mp-commits/Volvo_MELBUS_bluetooth_adapter/Casing/FreeCad/version1.FCStd

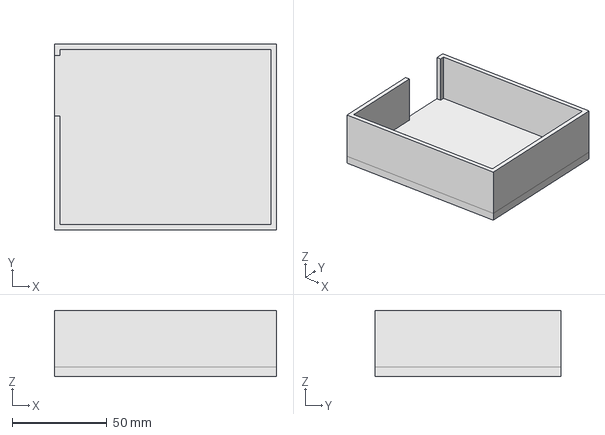
[picture p1: CAD file, 2022-04-23]
Casing/FreeCad/version1.FCStd
117.0 x 98.0 x 35.0 mm
