mp-commits/Volvo_MELBUS_bluetooth_adapter/KiCad/1.2/volvo_bt_board/volvo_bt_board.kicad_pcb

## KiCad design KiCad/1.2/volvo_bt_board/volvo_bt_board.kicad_pcb (2022-04-23)

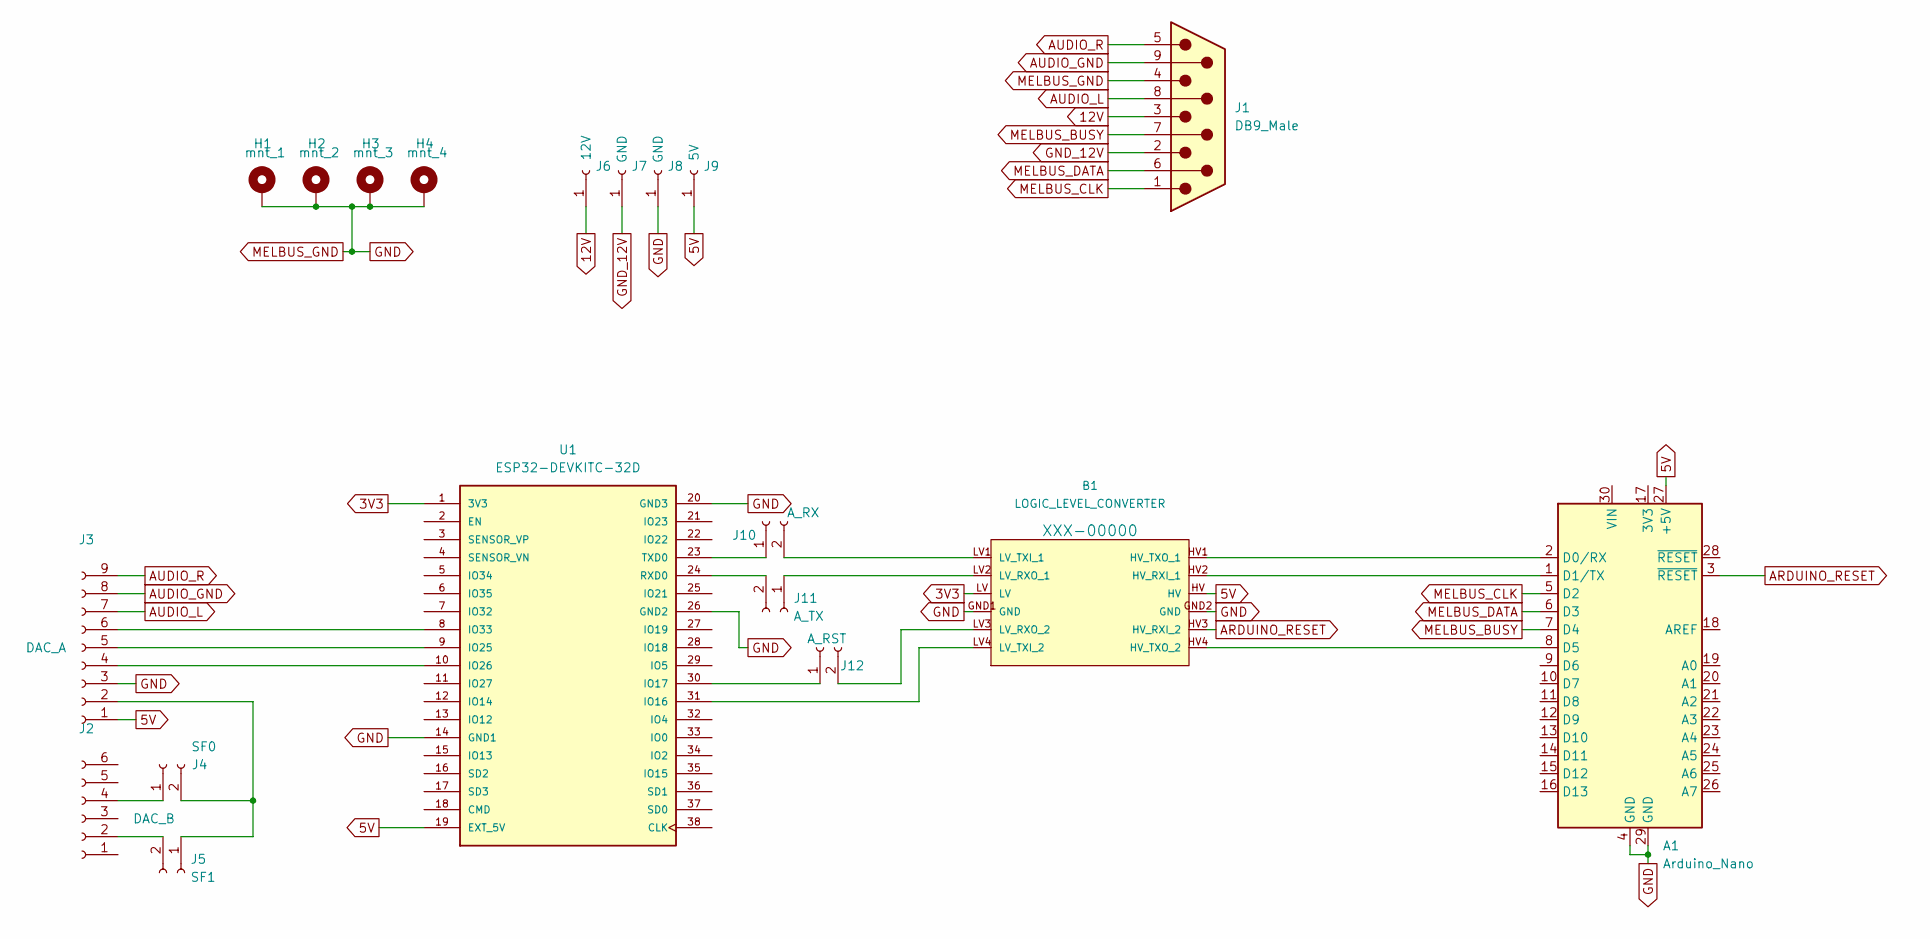
[picture p2: schematic volvo_bt_board.kicad_sch, Prototype Volvo MELBUS compatible bluetooth receiver]

Parts:
A1: Arduino_Nano
B1: LOGIC_LEVEL_CONVERTER; SPARKFUN_LOGIC_LEVEL_CONVERTER
H1: mnt_1; MountingHole_2.5mm_Pad
H2: mnt_2; MountingHole_2.5mm_Pad
H3: mnt_3; MountingHole_2.5mm_Pad
H4: mnt_4; MountingHole_2.5mm_Pad
J1: DB9_Male; DSUB-9_Male_Horizontal_P2.77x2.84mm_EdgePinOffset7.70mm_Hou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
J2: DAC_B; PinSocket_1x06_P2.54mm_Vertical
J3: DAC_A; PinSocket_1x09_P2.54mm_Vertical
J4: SF0; 1X02_NO_SILK
J5: SF1; 1X02_NO_SILK
J6: 12V; PinSocket_1x01_P2.54mm_Vertical
J7, J8: GND; PinSocket_1x01_P2.54mm_Vertical
J9: 5V; PinSocket_1x01_P2.54mm_Vertical
J10: A_RX; 1X02_NO_SILK
J11: A_TX; 1X02_NO_SILK
J12: A_RST; 1X02_NO_SILK
U1: ESP32-DEVKITC-32D; MODULE_ESP32-DEVKITC-32D; PARTREV 4

Connections:
3V3: B1.LV, U1.1 (3V3)
5V: A1.27 (+5V), B1.HV, J3.1, J9.1, U1.19 (EXT_5V)
12V: J1.3, J6.1
ARDUINO_RESET: A1.3 (~RESET), B1.HV3 (HV_RXI_2)
AUDIO_GND: J1.9, J3.8
AUDIO_L: J1.8, J3.7
AUDIO_R: J1.5, J3.9
GND: A1.4 (GND), A1.29 (GND), B1.GND1 (GND), B1.GND2 (GND), H1.1, H2.1, H3.1, H4.1, J1.4, J3.3, J8.1, U1.14 (GND1), U1.20 (GND3), U1.26 (GND2)
GND_12V: J1.2, J7.1
MELBUS_BUSY: A1.7 (D4), J1.7
MELBUS_CLK: A1.5 (D2), J1.1
MELBUS_DATA: A1.6 (D3), J1.6
unnamed: A1.1 (D1/TX), B1.HV2 (HV_RXI_1)
unnamed: A1.2 (D0/RX), B1.HV1 (HV_TXO_1)
unnamed: A1.8 (D5), B1.HV4 (HV_TXO_2)
unnamed: B1.LV1 (LV_TXI_1), J10.2
unnamed: B1.LV2 (LV_RXO_1), J11.1
unnamed: B1.LV3 (LV_RXO_2), J12.2
unnamed: B1.LV4 (LV_TXI_2), U1.31 (IO16)
unnamed: J2.2, J5.2
unnamed: J2.4, J4.1
unnamed: J3.2, J4.2, J5.1
unnamed: J3.4, U1.10 (IO26)
unnamed: J3.5, U1.9 (IO25)
unnamed: J3.6, U1.8 (IO33)
unnamed: J10.1, U1.23 (TXD0)
unnamed: J11.2, U1.24 (RXD0)
unnamed: J12.1, U1.30 (IO17)

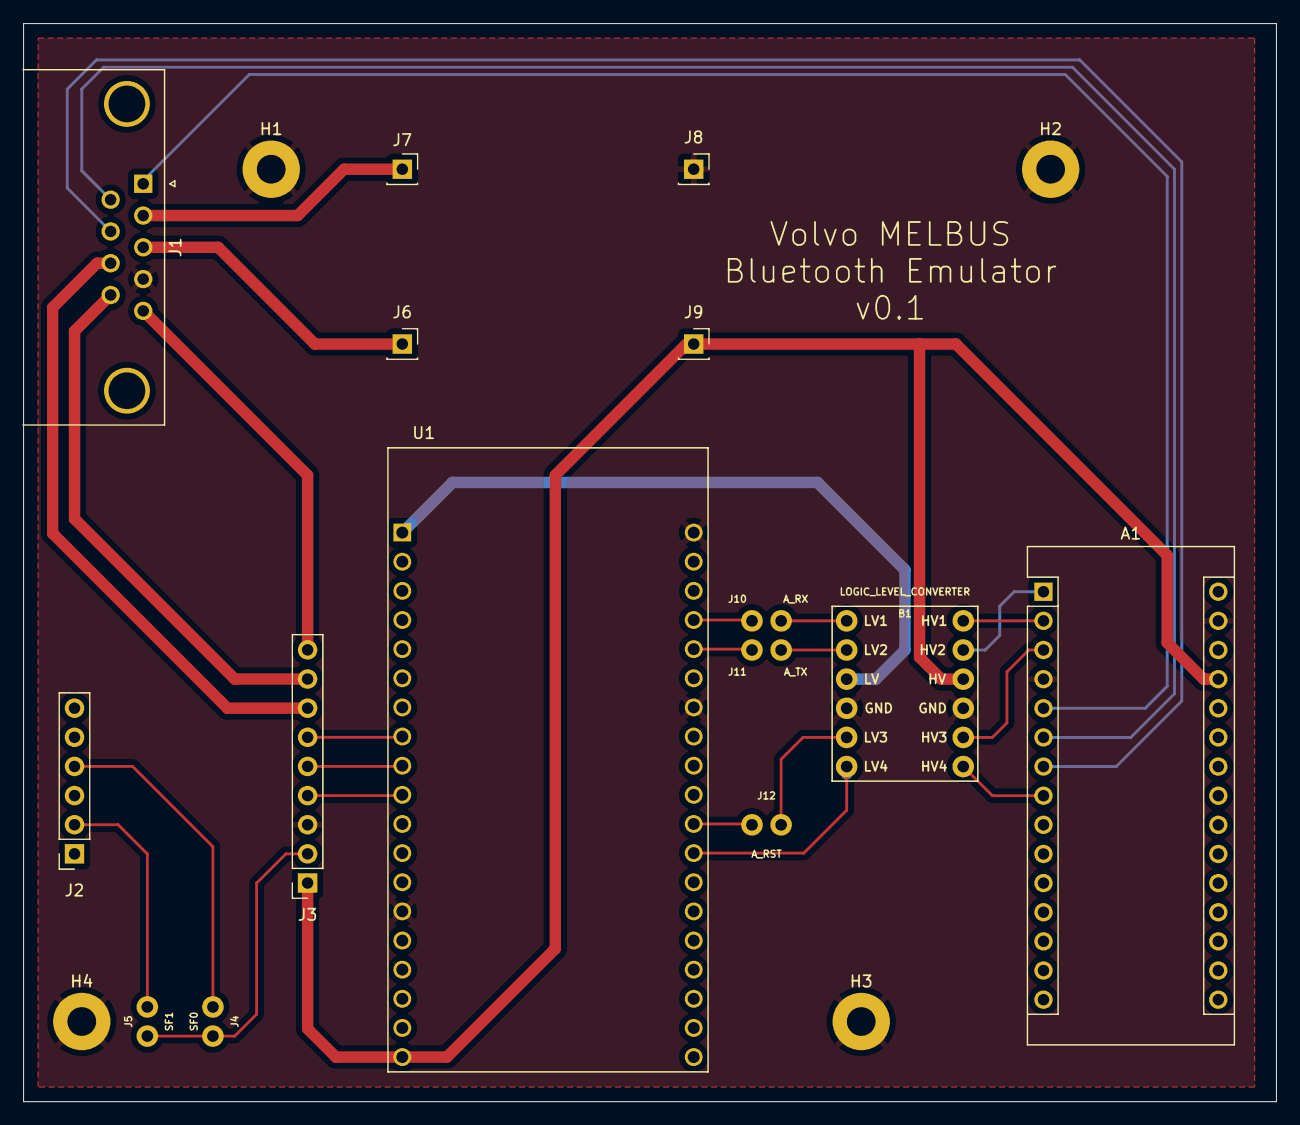
[picture p3: board volvo_bt_board.kicad_pcb from above]

Board: 2 copper layers, 109.2 x 94.0 mm, 19 parts (0 on the bottom side), 28 nets.
