mp-commits/Volvo_MELBUS_bluetooth_adapter/Bluetooth_receiver_ESP32/src/media/media_control.cpp

/**
 * @file media_control.cpp
 * @author Mikael Penttinen (mikael.penttinen3@gmail.com)
 * @brief 
 * @version 0.1
 * @date 2022-04-02
 * 
 * @copyright Copyright (c) 2022
 * 
 */
#include "media_control.h"
#include "Arduino.h"
#include "dev_print.h"

MediaControl::MediaControl()
{
    m_melbusInitDone = false;
    m_debugEnabled = false;
    m_sink = nullptr;
}

void MediaControl::SetSink(BluetoothA2DPSink* sink)
{
    m_sink = sink;
}

MediaControl::~MediaControl()
{

}

bool MediaControl::IsMelbusInitDone()
{
    return m_melbusInitDone;
}

void MediaControl::ResetMelbusInitDone()
{
    m_melbusInitDone = false;
}

void MediaControl::Task()
{
    if (m_sink == nullptr)
    {
        return;
    }

    MEDIA_Command_e mediaCommand = m_interface.TryGetCommand();
    if (mediaCommand != MEDIA_NO_COMMAND)
    {
        if (m_debugEnabled)
        {
            m_interface.SerialPrintCommand(mediaCommand);
        }

            switch (mediaCommand)
        {
        case MEDIA_PLAY:
            m_sink->play();
            break;
        case MEDIA_PAUSE:
            m_sink->pause();
            break;
        case MEDIA_NEXT_TRACK:
            m_sink->next();
            break;
        case MEDIA_PREVIOUS_TRACK:
            m_sink->previous();
            break;
        case MEDIA_NEXT_DISC:
            m_sink->set_volume(m_sink->get_volume()+10);
            PRINTF1("DAC Vol set to %i\n", m_sink->get_volume());
            break;
        case MEDIA_PREVIOUS_DISC:
            m_sink->set_volume(m_sink->get_volume()-10);
            PRINTF1("DAC Vol set to %i\n", m_sink->get_volume());
            break;
        case MEDIA_INFO_MELBUS_INIT_DONE:
            m_melbusInitDone = true;
            break;
        case MEDIA_FAST_FORWARD:
            m_sink->fast_forward();
            break;
        case MEDIA_FAST_REVERSE:
            m_sink->rewind();
            break;
        case MEDIA_RANDOM:
            RandomNextTrack();
        default:
            break;
        }
    }
}

void MediaControl::SetDebug(bool set)
{
    m_debugEnabled = set;
}

void MediaControl::RandomNextTrack()
{
    const uint32_t timeStamp = millis();
    const uint32_t skipCount = timeStamp % 7;
    for(uint32_t i = 0; i < skipCount; i++)
    {
        m_sink->next();
    }
}
