mp-commits/Volvo_MELBUS_bluetooth_adapter/Bluetooth_receiver_ESP32/include/melbus_controller.h

/**
 * @file melbus_controller.h
 * @author Mikael Penttinen (mikael.penttinen3@gmail.com)
 * @brief 
 * @version 0.1
 * @date 2022-04-03
 * 
 * @copyright Copyright (c) 2022
 * 
 */

#ifndef MELBUS_CONTROLLER_H
#define MELBUS_CONTROLLER_H

#include "project_pinconfig.h"
#include "media_control.h"
#include "Arduino.h"

#define MELBUS_INIT_TIMEOUT_MS 5000 // Allow 5 sec for melbus init before reset

class MelbusController
{
public:
    MelbusController(MediaControl* control);
    ~MelbusController();
    void Init();
    void Reset();
    void SetEnable(bool enable);

    void Task();
private:
    MediaControl* m_mediaControl;
    uint32_t m_initBeginTime_ms;
};

#endif
