mp-commits/Volvo_MELBUS_bluetooth_adapter/Bluetooth_receiver_ESP32/src/media/media_interface.cpp

/**
 * @file media_interface.cpp
 * @author Mikael Penttinen (mikael.penttinen3@gmail.com)
 * @brief 
 * @version 0.1
 * @date 2022-04-02
 * 
 * @copyright Copyright (c) 2022
 * 
 */

#include "media_interface.h"
#include "Arduino.h"
#include <stdint.h>
#include "dev_print.h"

// Bytes for decoding commands
#define COM_HEADER          (uint8_t)(0xA0)
#define COM_UNKNOWN         (uint8_t)(0x00)
#define COM_PLAY            (uint8_t)(0x01)
#define COM_PAUSE           (uint8_t)(0x02)
#define COM_NEXT            (uint8_t)(0x03)
#define COM_PREV            (uint8_t)(0x04)
#define COM_RANDOM          (uint8_t)(0x05)
#define COM_NEXT_DISC         (uint8_t)(0x06)
#define COM_PREVIOUS_DISC       (uint8_t)(0x07)
#define COM_FAST_FORWARD    (uint8_t)(0x08)
#define COM_FAST_REVERSE    (uint8_t)(0x09)
#define COM_SCAN_MODE       (uint8_t)(0x0A)

#define COM_INFO_HEADER     (uint8_t)(0xB0)
#define COM_INFO_UNKNOWN    (uint8_t)(0x00)
#define COM_INFO_INIT_BEGIN (uint8_t)(0x01)
#define COM_INFO_INIT_DONE  (uint8_t)(0x02)
#define COM_INFO_ALIVE      (uint8_t)(0x03)

#define COM_DATA_TRACK      (uint8_t)(0xAB)
#define COM_DATA_DISC       (uint8_t)(0xC0)

static MEDIA_Command_e TryDecodeCommand(const uint8_t byte);

MediaInterface::MediaInterface()
{

}

MediaInterface::~MediaInterface()
{

}

MEDIA_Command_e MediaInterface::TryGetCommand()
{
    MEDIA_Command_e command = MEDIA_NO_COMMAND;

    if (Serial.available() > 0)
    {
        uint8_t readByte = Serial.read();
        command = TryDecodeCommand(readByte);
    }

    return command;
}

void MediaInterface::SendTrackNumber(uint8_t track)
{
    uint8_t sendBuffer[2] = {COM_DATA_TRACK, track};
    Serial.write(sendBuffer, 2);
}

void MediaInterface::SendDiscNumber(uint8_t disc)
{
    uint8_t sendBuffer[2] = {COM_DATA_DISC, disc};
    Serial.write(sendBuffer, 2);
}

MEDIA_Command_e TryDecodeCommand(const uint8_t byte)
{
    MEDIA_Command_e command = MEDIA_NO_COMMAND;

    const uint8_t checkByte = byte & 0xF0;
    if (checkByte == COM_HEADER)
    {
        const uint8_t commandByte = byte & 0x0F;
        switch (commandByte)
        {
        case COM_UNKNOWN:
            command = MEDIA_UNKNOWN_COMMAND;
            break;
        case COM_PLAY:
            command = MEDIA_PLAY;
            break;
        case COM_PAUSE:
            command = MEDIA_PAUSE;
            break;
        case COM_NEXT:
            command = MEDIA_NEXT_TRACK;
            break;
        case COM_PREV:
            command = MEDIA_PREVIOUS_TRACK;
            break;
        case COM_RANDOM:
            command = MEDIA_RANDOM;
            break;
        case COM_NEXT_DISC:
            command = MEDIA_NEXT_DISC;
            break;
        case COM_PREVIOUS_DISC:
            command = MEDIA_PREVIOUS_DISC;
            break;
        case COM_FAST_FORWARD:
            command = MEDIA_FAST_FORWARD;
            break;
        case COM_FAST_REVERSE:
            command = MEDIA_FAST_REVERSE;
            break;
        case COM_SCAN_MODE:
            command = MEDIA_SCAN_MODE;
            break;

        default:
            command = MEDIA_UNKNOWN_COMMAND;
            break;
        }
    }
    else if (checkByte == COM_INFO_HEADER)
    {
        const uint8_t commandByte = byte & 0x0F;
        switch (commandByte)
        {
        case COM_INFO_UNKNOWN:
            command = MEDIA_UNKNOWN_COMMAND;
            break;
        case COM_INFO_INIT_BEGIN:
            command = MEDIA_INFO_MELBUS_INIT_BEGIN;
            break;
        case COM_INFO_INIT_DONE:
            command = MEDIA_INFO_MELBUS_INIT_DONE;
            break;
        case COM_INFO_ALIVE:
            command = MEDIA_INFO_ALIVE;
            break;

        default:
            command = MEDIA_UNKNOWN_COMMAND;
            break;
        }
    }
    else
    {
        command = MEDIA_NO_COMMAND;
    }

    return command;
}

void MediaInterface::SerialPrintCommand(MEDIA_Command_e command)
{
    switch (command)
    {
    case MEDIA_PLAY:
        PRINTLN("Mcmd: Play");
        break;
    case MEDIA_PAUSE:
        PRINTLN("Mcmd: Pause");
        break;
    case MEDIA_NEXT_TRACK:
        PRINTLN("Mcmd: Next");
        break;
    case MEDIA_PREVIOUS_TRACK:
        PRINTLN("Mcmd: Prev");
        break;
    case MEDIA_RANDOM:
        PRINTLN("Mcmd: Random");
        break;
    case MEDIA_SCAN_MODE:
        PRINTLN("Mcmd: Scan");
        break;
    case MEDIA_NEXT_DISC:
        PRINTLN("Mcmd: vol+");
        break;
    case MEDIA_PREVIOUS_DISC:
        PRINTLN("Mcmd: vol-");
        break;
    case MEDIA_FAST_FORWARD:
        PRINTLN("Mcmd: FF");
        break;
    case MEDIA_FAST_REVERSE:
        PRINTLN("Mcmd: FR");
        break;
    case MEDIA_UNKNOWN_COMMAND:
        PRINTLN("Mcmd: Unknown");
        break;
    case MEDIA_INFO_MELBUS_INIT_BEGIN:
        PRINTLN("Minfo: MELBUS init begin");
        break;
    case MEDIA_INFO_MELBUS_INIT_DONE:
        PRINTLN("Minfo: MELBUS init done");
        break;
    case MEDIA_INFO_ALIVE:
        static uint32_t aliveCounter = 0;
        PRINTF1("Minfo: MELBUS alive, %i\n", aliveCounter++);
    default:
        break;
    }
}
