mp-commits/Volvo_MELBUS_bluetooth_adapter/Arduino_melbus_sniffer/include/queue.h

/**
 * @file history.h
 * @author Mikael Penttinen (mikael.penttinen3@gmail.com)
 * @brief 
 * @version 0.1
 * @date 2022-03-04
 * 
 * @copyright Copyright (c) 2022
 * 
 */

#ifndef QUEUE_H
#define QUEUE_H

#include "melbus.h"

#define QUEUE_SIZE 128

class MelbusQueue 
{
public:
    MelbusQueue();
    void Push(const MELBUS_byte_t byte);
    MELBUS_byte_t Pop();
    uint32_t Size();
    uint32_t Count();
private:
    MELBUS_byte_t m_buffer[QUEUE_SIZE];
    uint32_t m_readIndex;
    uint32_t m_writeIndex;
    uint32_t m_bytesAvailable;
};

#endif
