mp-commits/Volvo_MELBUS_bluetooth_adapter/(commit log)

2022-04-02 Add esp32 receiver program
2022-04-03 Add enable signal to control device init
2022-04-04 Add pcb version 1
    [volvo_bt_board.kicad_pcb, volvo_bt_board.kicad_sch]
2022-04-04 Update pcb, generate gerber
    [volvo_bt_board-B_Cu.gbr, volvo_bt_board-B_Mask.gbr, volvo_bt_board-B_Paste.gbr, volvo_bt_board-B_Silkscreen.gbr, volvo_bt_board-Edge_Cuts.gbr, volvo_bt_board-F_Cu.gbr, volvo_bt_board-F_Mask.gbr, volvo_bt_board-F_Paste.gbr]
2022-04-08 Update project
    [volvo_bt_board.kicad_pcb]
2022-04-10 Add second better version of pcb
    [volvo_bt_board-B_Cu.gbl, volvo_bt_board-B_Cu.gbr, volvo_bt_board-B_Mask.gbr, volvo_bt_board-B_Mask.gbs, volvo_bt_board-B_Paste.gbp, volvo_bt_board-B_Paste.gbr, volvo_bt_board-B_Silkscreen.gbo, volvo_bt_board-B_Silkscreen.gbr]
2022-04-10 Fix esp init logic
    [main.cpp]
2022-04-23 Add support for fast forward and reverse
    - Add support for scanmode (not tested)
    - Add ack bytes for approriate commands
    - Add board version 1.2
    [version1.FCStd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]
